noahmarshall415/ECE532-Project-Repo/ip_repo/sensor_logic_4.0/hdl/sensor_logic_v4_0.v

`timescale 1 ns / 1 ps

module sensor_logic_v4_0 #
(
    parameter integer THRESHOLD = 36,
    parameter integer DIST_REG_ADDR = 32'h00000000,

    parameter  C_M00_AXI_START_DATA_VALUE = 32'hAA000000,
    parameter  C_M00_AXI_TARGET_SLAVE_BASE_ADDR = 32'h40000000,
    parameter integer C_M00_AXI_ADDR_WIDTH = 32,
    parameter integer C_M00_AXI_DATA_WIDTH = 32,
    parameter integer C_M00_AXI_TRANSACTIONS_NUM = 4
)
(
    output wire [15:0] leds,
    output wire audio,

    input wire  m00_axi_aclk,
    input wire  m00_axi_aresetn,
    output wire [C_M00_AXI_ADDR_WIDTH-1 : 0] m00_axi_awaddr,
    output wire  m00_axi_awvalid,
    input wire  m00_axi_awready,
    output wire [C_M00_AXI_DATA_WIDTH-1 : 0] m00_axi_wdata,
    output wire  m00_axi_wvalid,
    input wire  m00_axi_wready,
    input wire [1 : 0] m00_axi_bresp,
    input wire  m00_axi_bvalid,
    output wire  m00_axi_bready,
    output wire [C_M00_AXI_ADDR_WIDTH-1 : 0] m00_axi_araddr,
    output wire  m00_axi_arvalid,
    input wire  m00_axi_arready,
    input wire [C_M00_AXI_DATA_WIDTH-1 : 0] m00_axi_rdata,
    input wire [1 : 0] m00_axi_rresp,
    input wire  m00_axi_rvalid,
    output wire  m00_axi_rready
);

    sensor_logic_v4_0_M00_AXI #(
        .C_M_START_DATA_VALUE(C_M00_AXI_START_DATA_VALUE),
        .C_M_TARGET_SLAVE_BASE_ADDR(DIST_REG_ADDR),   
        .C_M_AXI_ADDR_WIDTH(C_M00_AXI_ADDR_WIDTH),
        .C_M_AXI_DATA_WIDTH(C_M00_AXI_DATA_WIDTH),
        .C_M_TRANSACTIONS_NUM(C_M00_AXI_TRANSACTIONS_NUM),
        .THRESHOLD(THRESHOLD)
    ) sensor_logic_v4_0_M00_AXI_inst (
        .M_AXI_ACLK(m00_axi_aclk),
        .M_AXI_ARESETN(m00_axi_aresetn),
        .M_AXI_AWADDR(m00_axi_awaddr),
        .M_AXI_AWVALID(m00_axi_awvalid),
        .M_AXI_AWREADY(m00_axi_awready),
        .M_AXI_WDATA(m00_axi_wdata),
        .M_AXI_WVALID(m00_axi_wvalid),
        .M_AXI_WREADY(m00_axi_wready),
        .M_AXI_BRESP(m00_axi_bresp),
        .M_AXI_BVALID(m00_axi_bvalid),
        .M_AXI_BREADY(m00_axi_bready),
        .M_AXI_ARADDR(m00_axi_araddr),
        .M_AXI_ARVALID(m00_axi_arvalid),
        .M_AXI_ARREADY(m00_axi_arready),
        .M_AXI_RDATA(m00_axi_rdata),
        .M_AXI_RRESP(m00_axi_rresp),
        .M_AXI_RVALID(m00_axi_rvalid),
        .M_AXI_RREADY(m00_axi_rready),

        // LED output
        .AUDIO_OUT(audio),
        .LED_OUT(leds)
    );

endmodule
