noahmarshall415/ECE532-Project-Repo/camera_configure.v

`timescale 1ns / 1ps

module camera_configure
    #(
    parameter CLK_FREQ=25000000
    )
    (
    input wire clk,
    input wire start,
    output wire sioc,
    output wire siod,
    output wire done
    );
    
    wire [7:0] rom_addr;
    wire [15:0] rom_dout;
    wire [7:0] SCCB_addr;
    wire [7:0] SCCB_data;
    wire SCCB_start;
    wire SCCB_ready;
    wire SCCB_SIOC_oe;
    wire SCCB_SIOD_oe;
    
    assign sioc = SCCB_SIOC_oe ? 1'b0 : 1'bZ;
    assign siod = SCCB_SIOD_oe ? 1'b0 : 1'bZ;
    
    OV7670_config_rom rom1(
        .clk(clk),
        .addr(rom_addr),
        .o_dout(rom_dout)
        );
        
    OV7670_config #(.CLK_FREQ(CLK_FREQ)) config_1(
        .clk(clk),
        .SCCB_interface_ready(SCCB_ready),
        .rom_data(rom_dout),
        .start(start),
        .rom_addr(rom_addr),
        .done(done),
        .SCCB_interface_addr(SCCB_addr),
        .SCCB_interface_data(SCCB_data),
        .SCCB_interface_start(SCCB_start)
        );
    
    SCCB_interface #( .CLK_FREQ(CLK_FREQ)) SCCB1(
        .clk(clk),
        .start(SCCB_start),
        .address(SCCB_addr),
        .data(SCCB_data),
        .ready(SCCB_ready),
        .SIOC_oe(SCCB_SIOC_oe),
        .SIOD_oe(SCCB_SIOD_oe)
        );
    
endmodule
